diesson/buck_interleaved/Figuras/layout.png

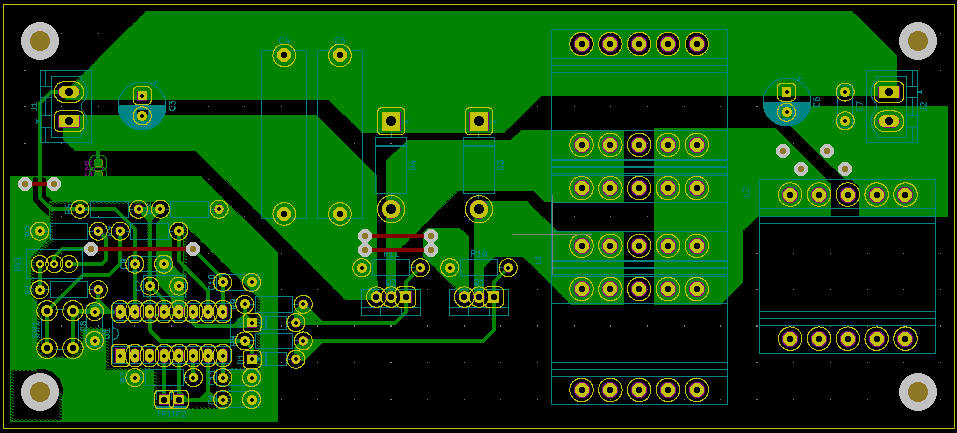
Figuras/layout.png
