diesson/buck_interleaved/Scripts/fig/cond/Acoplado com frequência de chaveamento 20kHz (Entreferro grande).png

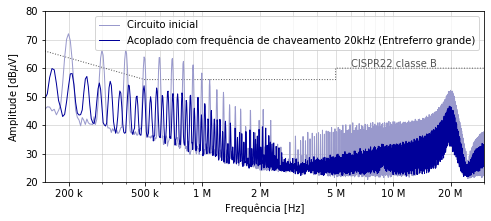
Scripts/fig/cond/Acoplado com frequência de chaveamento 20kHz (Entreferro grande).png
