diesson/buck_interleaved/Scripts/fig/cond/Alteração da posição do indutor.png

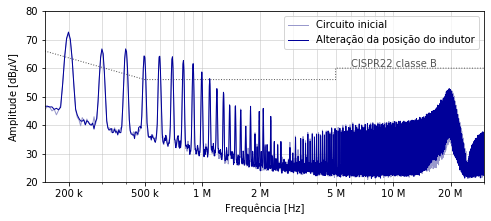
Scripts/fig/cond/Alteração da posição do indutor.png
