diesson/buck_interleaved/Scripts/fig/cond/Choke bead no terminal de dreno do transistor.png

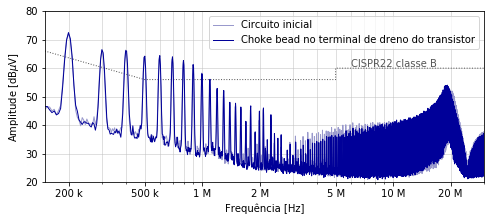
Scripts/fig/cond/Choke bead no terminal de dreno do transistor.png
