diesson/buck_interleaved/Scripts/fig/cond/Circuito inicial.png

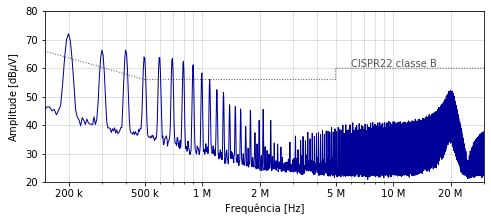
Scripts/fig/cond/Circuito inicial.png
