diesson/buck_interleaved/Scripts/fig/cond/Conectar o dissipador a referência (Capacitor de 1nF).png

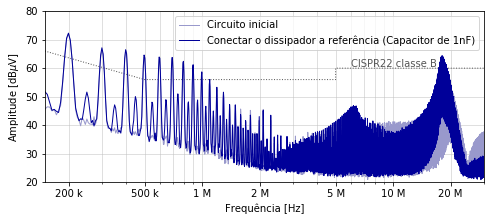
Scripts/fig/cond/Conectar o dissipador a referência (Capacitor de 1nF).png
