diesson/buck_interleaved/Scripts/fig/cond/Medida que n serve pra nada.png

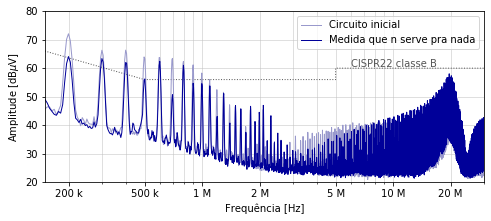
Scripts/fig/cond/Medida que n serve pra nada.png
