diesson/buck_interleaved/Scripts/fig/cond/Tensão Vgs 12V.png

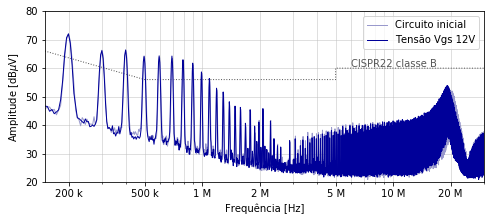
Scripts/fig/cond/Tensão Vgs 12V.png
