diesson/buck_interleaved/Scripts/fig/cond/Uso das melhores técnicas.png

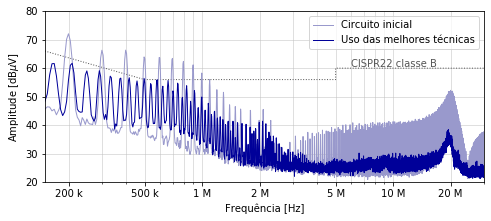
Scripts/fig/cond/Uso das melhores técnicas.png
