diesson/buck_interleaved/Scripts/fig/cond/Uso de um acoplado com frequência de chaveamento de 20kHz.png

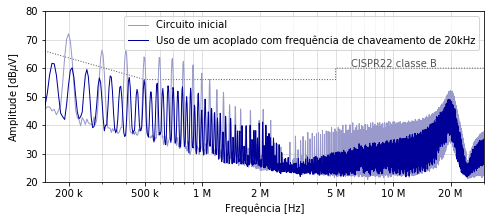
Scripts/fig/cond/Uso de um acoplado com frequência de chaveamento de 20kHz.png
