diesson/buck_interleaved/Scripts/fig/rad/Acoplado com frequência de chaveamento 20kHz (Entreferro grande).png

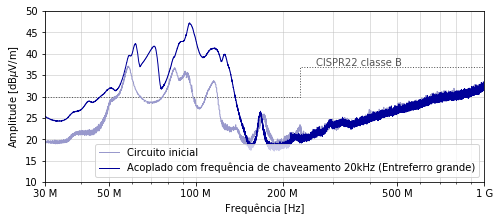
Scripts/fig/rad/Acoplado com frequência de chaveamento 20kHz (Entreferro grande).png
