diesson/buck_interleaved/Scripts/fig/rad/Acoplado com frequência de chaveamento 50kHz (Entreferro pequeno e indutor embaixo da placa).png

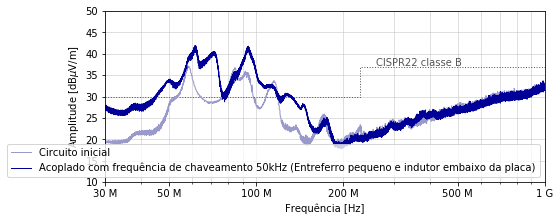
Scripts/fig/rad/Acoplado com frequência de chaveamento 50kHz (Entreferro pequeno e indutor embaixo da placa).png
