diesson/buck_interleaved/Scripts/fig/rad/Alteração da posição do indutor.png

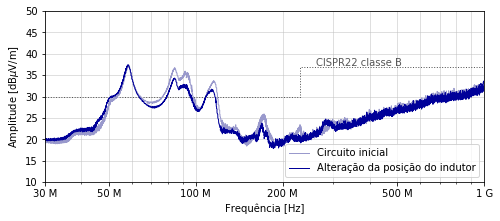
Scripts/fig/rad/Alteração da posição do indutor.png
