diesson/buck_interleaved/Scripts/fig/rad/Aumento do tr do transistor.png

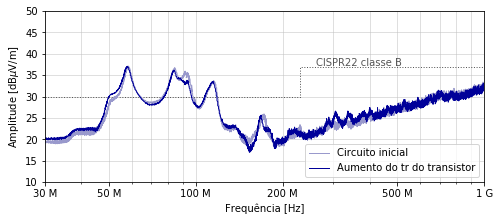
Scripts/fig/rad/Aumento do tr do transistor.png
