diesson/buck_interleaved/Scripts/fig/rad/Choke bead no terminal de dreno do transistor.png

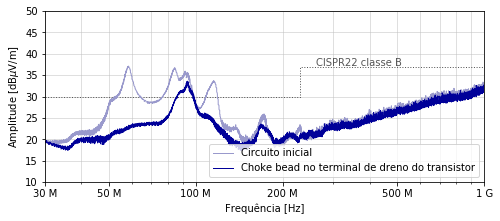
Scripts/fig/rad/Choke bead no terminal de dreno do transistor.png
