diesson/buck_interleaved/Scripts/fig/rad/Conectar o dissipador a referência (Capacitor de 1nF).png

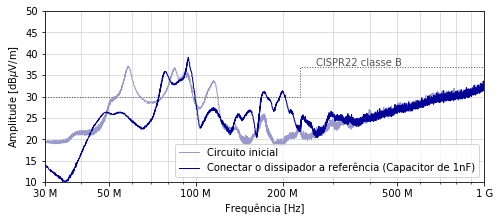
Scripts/fig/rad/Conectar o dissipador a referência (Capacitor de 1nF).png
