diesson/buck_interleaved/Scripts/fig/rad/Conectar o dissipador a referência (Capacitor de 100nF).png

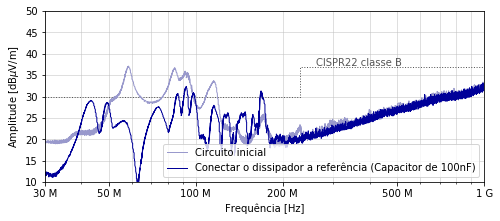
Scripts/fig/rad/Conectar o dissipador a referência (Capacitor de 100nF).png
