diesson/buck_interleaved/Scripts/fig/rad/Uso das melhores técnicas.png

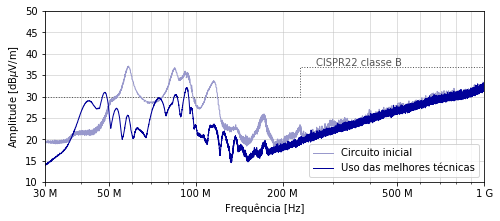
Scripts/fig/rad/Uso das melhores técnicas.png
