diesson/buck_interleaved/Scripts/fig/rad/Uso de um acoplado com frequência de chaveamento de 20kHz.png

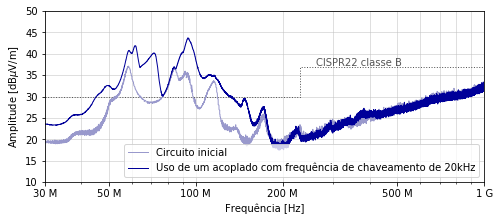
Scripts/fig/rad/Uso de um acoplado com frequência de chaveamento de 20kHz.png
