diesson/buck_interleaved/Scripts/fig/rad/Uso de um acoplado com frequência de chaveamento de 50kHz.png

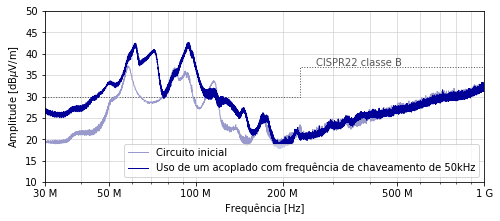
Scripts/fig/rad/Uso de um acoplado com frequência de chaveamento de 50kHz.png
