diesson/buck_interleaved/Scripts/TESTE/00_eixo_freq.xls

Frequency | PK+_CLRWR | Axis | Corr. | Comment
MHz | dBμV |  | dB
 | MaxPeak
Lin | Lin | Lin | Lin | Lin
30.000000 | --- |  | ---
30.040000 | --- |  | ---
30.080000 | --- |  | ---
30.120000 | --- |  | ---
30.160000 | --- |  | ---
30.200000 | --- |  | ---
30.240000 | --- |  | ---
30.280000 | --- |  | ---
30.320000 | --- |  | ---
30.360000 | --- |  | ---
30.400000 | --- |  | ---
30.440000 | --- |  | ---
30.480000 | --- |  | ---
30.520000 | --- |  | ---
30.560000 | --- |  | ---
30.600000 | --- |  | ---
30.640000 | --- |  | ---
30.680000 | --- |  | ---
30.720000 | --- |  | ---
30.760000 | --- |  | ---
30.800000 | --- |  | ---
30.840000 | --- |  | ---
30.880000 | --- |  | ---
30.920000 | --- |  | ---
30.960000 | --- |  | ---
31.000000 | --- |  | ---
31.040000 | --- |  | ---
31.080000 | --- |  | ---
31.120000 | --- |  | ---
31.160000 | --- |  | ---
31.200000 | --- |  | ---
31.240000 | --- |  | ---
31.280000 | --- |  | ---
31.320000 | --- |  | ---
31.360000 | --- |  | ---
31.400000 | --- |  | ---
31.440000 | --- |  | ---
31.480000 | --- |  | ---
31.520000 | --- |  | ---
31.560000 | --- |  | ---
31.600000 | --- |  | ---
31.640000 | --- |  | ---
31.680000 | --- |  | ---
31.720000 | --- |  | ---
31.760000 | --- |  | ---
31.800000 | --- |  | ---
31.840000 | --- |  | ---
31.880000 | --- |  | ---
31.920000 | --- |  | ---
31.960000 | --- |  | ---
32.000000 | --- |  | ---
32.040000 | --- |  | ---
32.080000 | --- |  | ---
32.120000 | --- |  | ---
32.160000 | --- |  | ---
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
188.680000 | --- |  | ---
188.720000 | --- |  | ---
188.760000 | --- |  | ---
188.800000 | --- |  | ---
188.840000 | --- |  | ---
188.880000 | --- |  | ---
188.920000 | --- |  | ---
188.960000 | --- |  | ---
189.000000 | --- |  | ---
189.040000 | --- |  | ---
189.080000 | --- |  | ---
189.120000 | --- |  | ---
189.160000 | --- |  | ---
189.200000 | --- |  | ---
189.240000 | --- |  | ---
189.280000 | --- |  | ---
189.320000 | --- |  | ---
189.360000 | --- |  | ---
189.400000 | --- |  | ---
189.440000 | --- |  | ---
189.480000 | --- |  | ---
189.520000 | --- |  | ---
189.560000 | --- |  | ---
189.600000 | --- |  | ---
189.640000 | --- |  | ---
189.680000 | --- |  | ---
189.720000 | --- |  | ---
189.760000 | --- |  | ---
189.800000 | --- |  | ---
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
