diesson/buck_interleaved/Scripts/TESTE/02_contra_porta_FD.xls

Frequency | PK+_CLRWR | Axis | Corr. | Comment
MHz | dBμV |  | dB
 | MaxPeak
Lin | Lin | Lin | Lin | Lin
30.000000 | 45.3 |  | 0.0
30.040000 | 45.3 |  | 0.0
30.080000 | 45.6 |  | 0.0
30.120000 | 45.6 |  | 0.0
30.160000 | 45.7 |  | 0.0
30.200000 | 45.4 |  | 0.0
30.240000 | 45.1 |  | 0.0
30.280000 | 45.2 |  | 0.0
30.320000 | 45.3 |  | 0.0
30.360000 | 45.7 |  | 0.0
30.400000 | 45.5 |  | 0.0
30.440000 | 45.2 |  | 0.0
30.480000 | 45.0 |  | 0.0
30.520000 | 45.0 |  | 0.0
30.560000 | 45.4 |  | 0.0
30.600000 | 45.4 |  | 0.0
30.640000 | 45.3 |  | 0.0
30.680000 | 45.1 |  | 0.0
30.720000 | 44.9 |  | 0.0
30.760000 | 45.0 |  | 0.0
30.800000 | 45.1 |  | 0.0
30.840000 | 45.4 |  | 0.0
30.880000 | 45.3 |  | 0.0
30.920000 | 44.9 |  | 0.0
30.960000 | 44.7 |  | 0.0
31.000000 | 44.7 |  | 0.0
31.040000 | 45.1 |  | 0.0
31.080000 | 45.2 |  | 0.0
31.120000 | 45.0 |  | 0.0
31.160000 | 44.8 |  | 0.0
31.200000 | 44.6 |  | 0.0
31.240000 | 44.7 |  | 0.0
31.280000 | 44.9 |  | 0.0
31.320000 | 45.0 |  | 0.0
31.360000 | 45.0 |  | 0.0
31.400000 | 44.7 |  | 0.0
31.440000 | 44.4 |  | 0.0
31.480000 | 44.5 |  | 0.0
31.520000 | 44.8 |  | 0.0
31.560000 | 45.1 |  | 0.0
31.600000 | 44.8 |  | 0.0
31.640000 | 44.5 |  | 0.0
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
