diesson/buck_interleaved/Scripts/TESTE/03_contra_porta_FE.xls

Frequency | PK+_CLRWR | Axis | Corr. | Comment
MHz | dBμV |  | dB
 | MaxPeak
Lin | Lin | Lin | Lin | Lin
30.000000 | 43.5 |  | 0.0
30.040000 | 43.8 |  | 0.0
30.080000 | 43.9 |  | 0.0
30.120000 | 44.0 |  | 0.0
30.160000 | 43.9 |  | 0.0
30.200000 | 43.5 |  | 0.0
30.240000 | 43.4 |  | 0.0
30.280000 | 43.5 |  | 0.0
30.320000 | 44.0 |  | 0.0
30.360000 | 44.1 |  | 0.0
30.400000 | 43.6 |  | 0.0
30.440000 | 43.4 |  | 0.0
30.480000 | 43.3 |  | 0.0
30.520000 | 43.6 |  | 0.0
30.560000 | 43.9 |  | 0.0
30.600000 | 43.8 |  | 0.0
30.640000 | 43.6 |  | 0.0
30.680000 | 43.3 |  | 0.0
30.720000 | 43.2 |  | 0.0
30.760000 | 43.5 |  | 0.0
30.800000 | 43.7 |  | 0.0
30.840000 | 43.9 |  | 0.0
30.880000 | 43.4 |  | 0.0
30.920000 | 43.1 |  | 0.0
30.960000 | 43.0 |  | 0.0
31.000000 | 43.4 |  | 0.0
31.040000 | 43.7 |  | 0.0
31.080000 | 43.6 |  | 0.0
31.120000 | 43.4 |  | 0.0
31.160000 | 43.1 |  | 0.0
31.200000 | 43.0 |  | 0.0
31.240000 | 43.2 |  | 0.0
31.280000 | 43.4 |  | 0.0
31.320000 | 43.7 |  | 0.0
31.360000 | 43.3 |  | 0.0
31.400000 | 43.0 |  | 0.0
31.440000 | 42.8 |  | 0.0
31.480000 | 43.1 |  | 0.0
31.520000 | 43.5 |  | 0.0
31.560000 | 43.5 |  | 0.0
31.600000 | 43.0 |  | 0.0
31.640000 | 42.9 |  | 0.0
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
