diesson/buck_interleaved/Scripts/TESTE/04_ponta.xls

Frequency | PK+_CLRWR | Axis | Corr. | Comment
MHz | dBμV |  | dB
 | MaxPeak
Lin | Lin | Lin | Lin | Lin
30.000000 | 28.4 |  | 0.0
30.040000 | 29.0 |  | 0.0
30.080000 | 29.3 |  | 0.0
30.120000 | 30.8 |  | 0.0
30.160000 | 30.5 |  | 0.0
30.200000 | 29.5 |  | 0.0
30.240000 | 28.2 |  | 0.0
30.280000 | 28.6 |  | 0.0
30.320000 | 30.2 |  | 0.0
30.360000 | 30.6 |  | 0.0
30.400000 | 30.2 |  | 0.0
30.440000 | 29.2 |  | 0.0
30.480000 | 29.0 |  | 0.0
30.520000 | 29.1 |  | 0.0
30.560000 | 30.1 |  | 0.0
30.600000 | 30.6 |  | 0.0
30.640000 | 30.9 |  | 0.0
30.680000 | 29.2 |  | 0.0
30.720000 | 28.0 |  | 0.0
30.760000 | 28.3 |  | 0.0
30.800000 | 30.3 |  | 0.0
30.840000 | 30.9 |  | 0.0
30.880000 | 30.6 |  | 0.0
30.920000 | 29.3 |  | 0.0
30.960000 | 28.7 |  | 0.0
31.000000 | 29.3 |  | 0.0
31.040000 | 30.2 |  | 0.0
31.080000 | 30.6 |  | 0.0
31.120000 | 30.5 |  | 0.0
31.160000 | 29.8 |  | 0.0
31.200000 | 29.0 |  | 0.0
31.240000 | 28.6 |  | 0.0
31.280000 | 30.3 |  | 0.0
31.320000 | 31.2 |  | 0.0
31.360000 | 30.5 |  | 0.0
31.400000 | 29.1 |  | 0.0
31.440000 | 28.3 |  | 0.0
31.480000 | 29.2 |  | 0.0
31.520000 | 31.0 |  | 0.0
31.560000 | 31.0 |  | 0.0
31.600000 | 30.3 |  | 0.0
31.640000 | 29.4 |  | 0.0
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
