diesson/buck_interleaved/Scripts/TESTE/05_contra_ponta.xls

Frequency | PK+_CLRWR | Axis | Corr. | Comment
MHz | dBμV |  | dB
 | MaxPeak
Lin | Lin | Lin | Lin | Lin
30.000000 | 29.5 |  | 0.0
30.040000 | 30.0 |  | 0.0
30.080000 | 30.1 |  | 0.0
30.120000 | 28.9 |  | 0.0
30.160000 | 28.3 |  | 0.0
30.200000 | 28.1 |  | 0.0
30.240000 | 28.6 |  | 0.0
30.280000 | 30.6 |  | 0.0
30.320000 | 30.3 |  | 0.0
30.360000 | 28.5 |  | 0.0
30.400000 | 27.6 |  | 0.0
30.440000 | 27.9 |  | 0.0
30.480000 | 30.2 |  | 0.0
30.520000 | 30.4 |  | 0.0
30.560000 | 30.3 |  | 0.0
30.600000 | 28.6 |  | 0.0
30.640000 | 28.1 |  | 0.0
30.680000 | 29.0 |  | 0.0
30.720000 | 29.1 |  | 0.0
30.760000 | 30.6 |  | 0.0
30.800000 | 30.7 |  | 0.0
30.840000 | 29.1 |  | 0.0
30.880000 | 27.8 |  | 0.0
30.920000 | 27.9 |  | 0.0
30.960000 | 30.0 |  | 0.0
31.000000 | 30.8 |  | 0.0
31.040000 | 30.3 |  | 0.0
31.080000 | 28.5 |  | 0.0
31.120000 | 28.1 |  | 0.0
31.160000 | 28.7 |  | 0.0
31.200000 | 29.7 |  | 0.0
31.240000 | 30.3 |  | 0.0
31.280000 | 30.2 |  | 0.0
31.320000 | 29.6 |  | 0.0
31.360000 | 28.2 |  | 0.0
31.400000 | 28.4 |  | 0.0
31.440000 | 29.8 |  | 0.0
31.480000 | 30.8 |  | 0.0
31.520000 | 30.2 |  | 0.0
31.560000 | 28.9 |  | 0.0
31.600000 | 27.6 |  | 0.0
31.640000 | 28.8 |  | 0.0
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
