diesson/buck_interleaved/Scripts/fig/cond/pdf/Uso de um acoplado com frequência de chaveamento de 20kHz.pdf

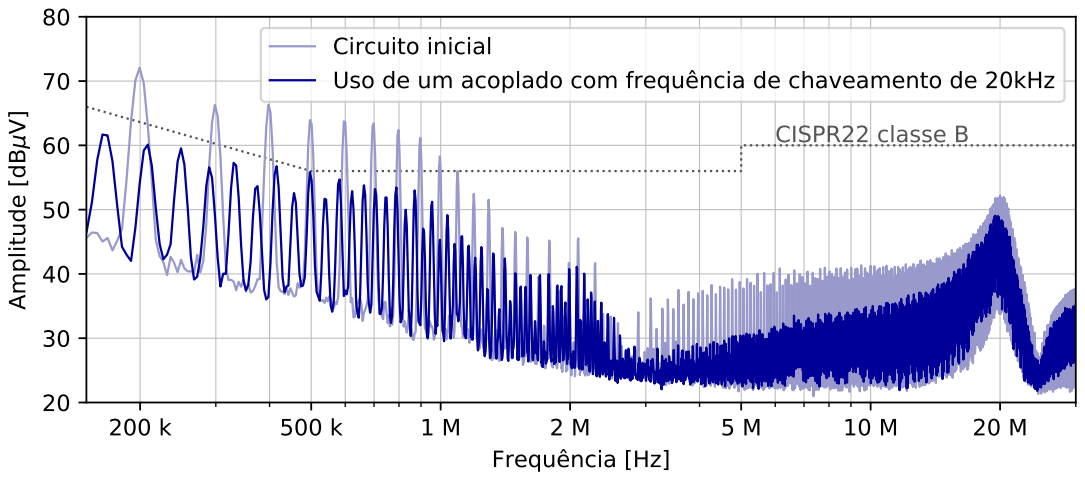
[picture p23: page 1]
Frequência [Hz]; plitu

Circuito inicial Uso de um acoplado com frequência de chaveamento de 20kHz

CISPR22 classe B
