diesson/buck_interleaved/Scripts/fig/cond/pdf/Uso de um acoplado com frequência de chaveamento de 50kHz.pdf

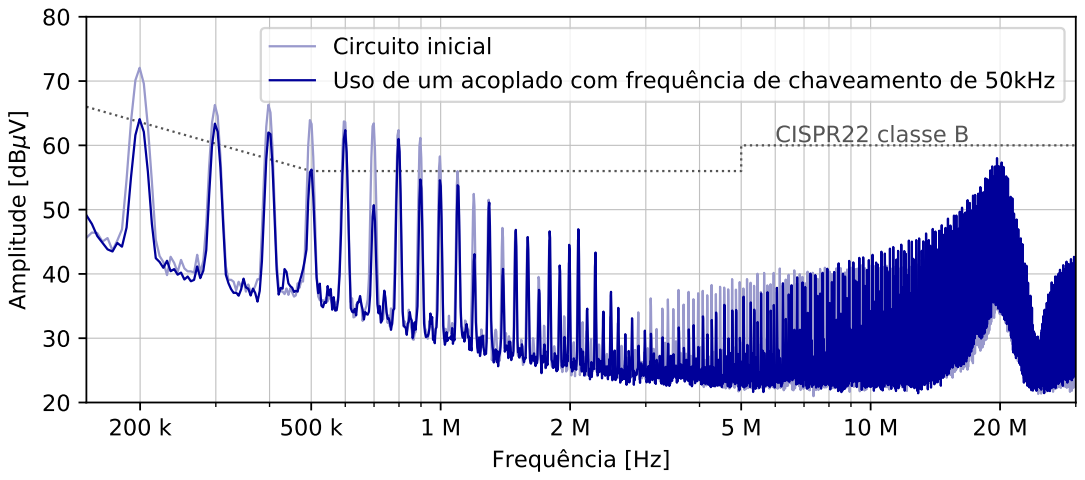
[picture p24: page 1]
Frequência [Hz]; plitu

Circuito inicial Uso de um acoplado com frequência de chaveamento de 50kHz

CISPR22 classe B
