diesson/buck_interleaved/Scripts/fig/rad/pdf/Uso de um acoplado com frequência de chaveamento de 20kHz.pdf

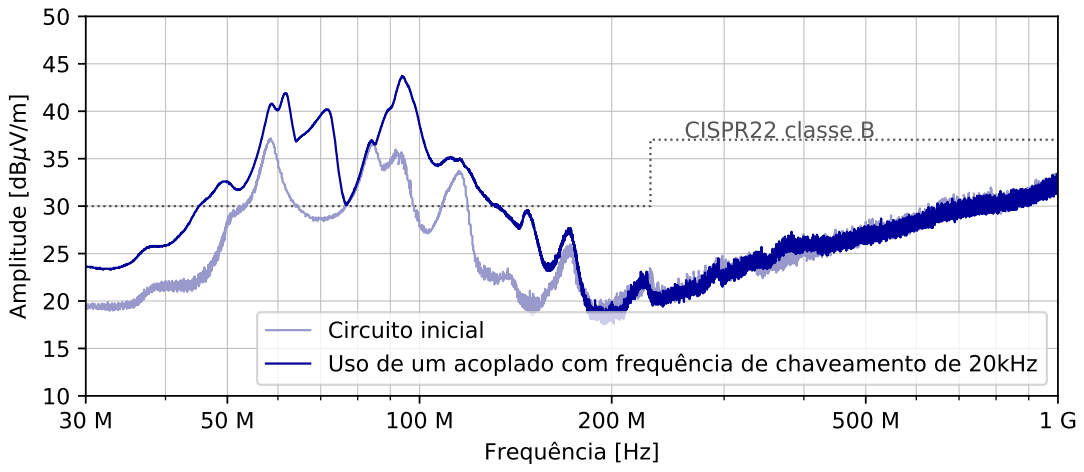
[picture p25: page 1]
Frequência [Hz]; plitu; CISPR22 classe B

Circuito inicial
Uso de um acoplado com frequência de chaveamento de 20kHz
