diesson/buck_interleaved/Circuito.pdf

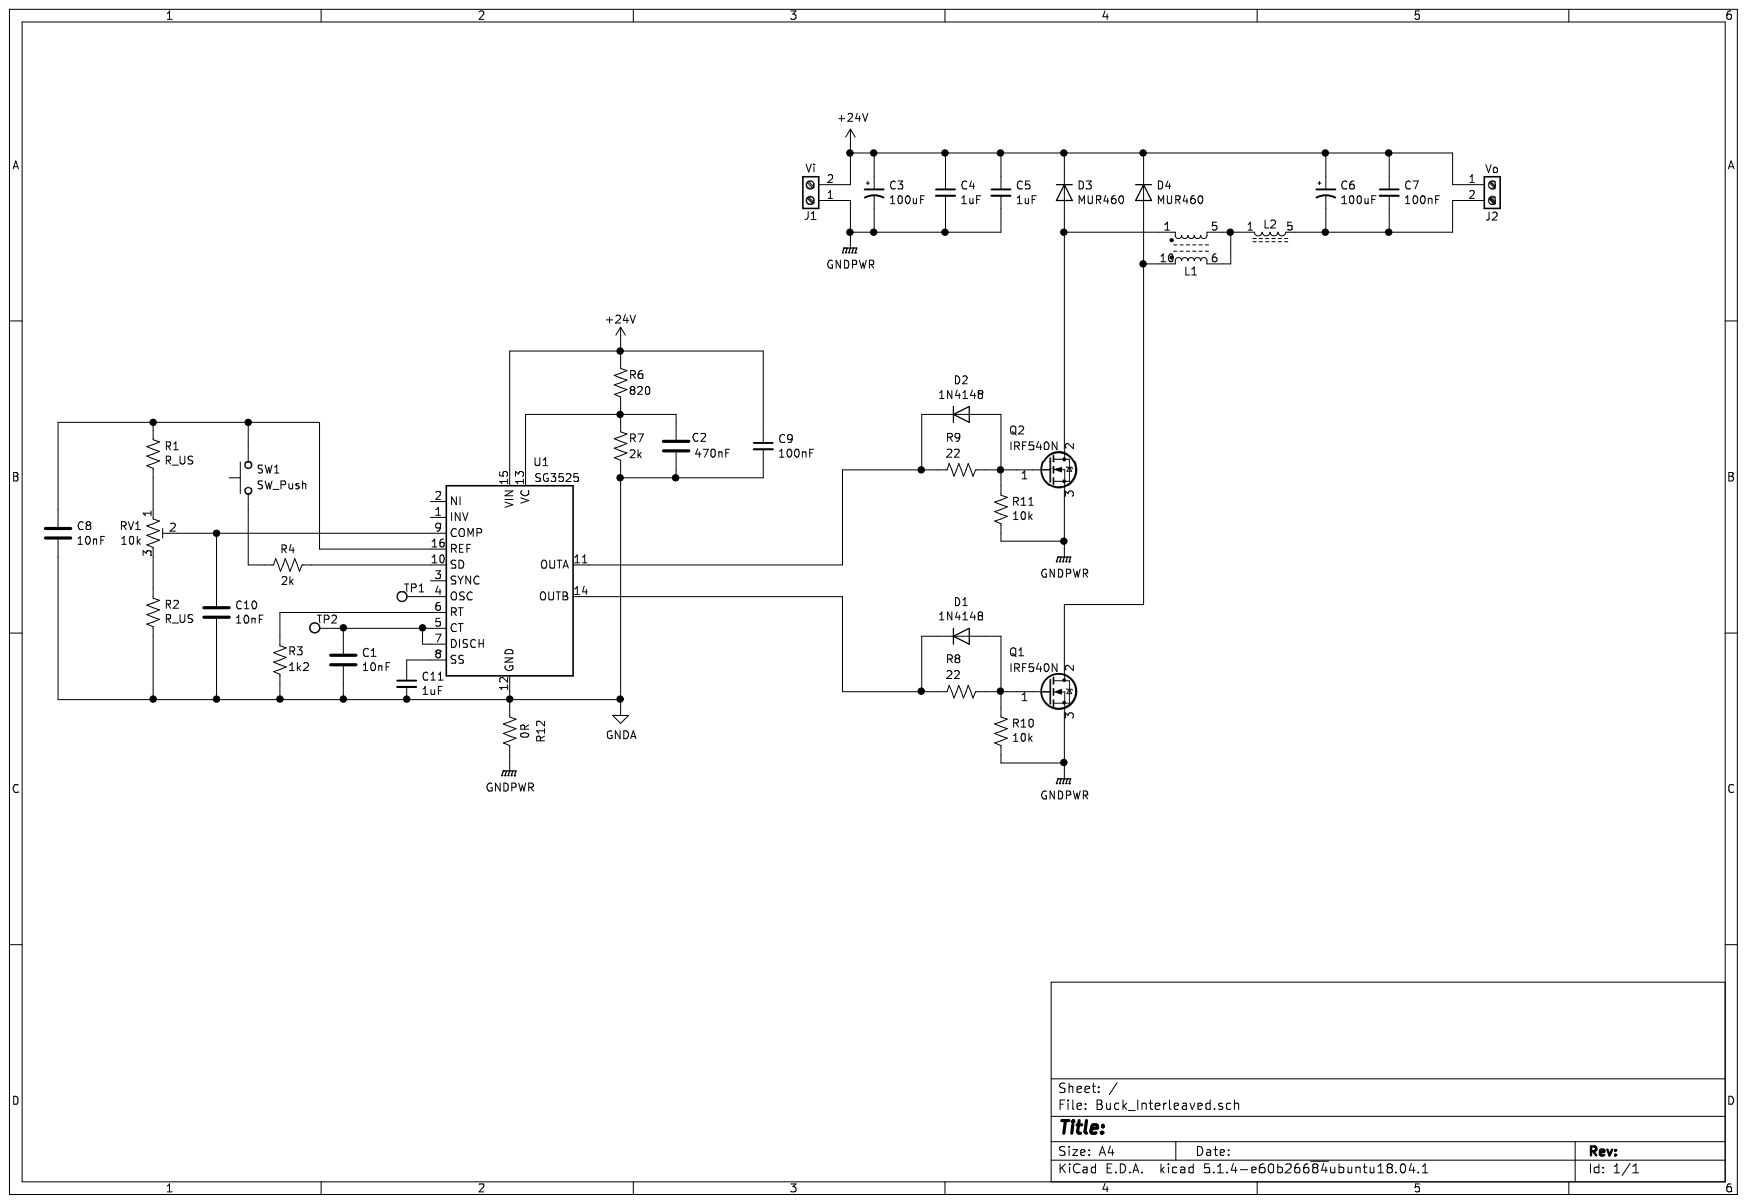
[picture p26: page 1]
