diesson/buck_interleaved/Scripts/fig/cond/pdf/Choke bead no terminal de dreno do transistor.pdf

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

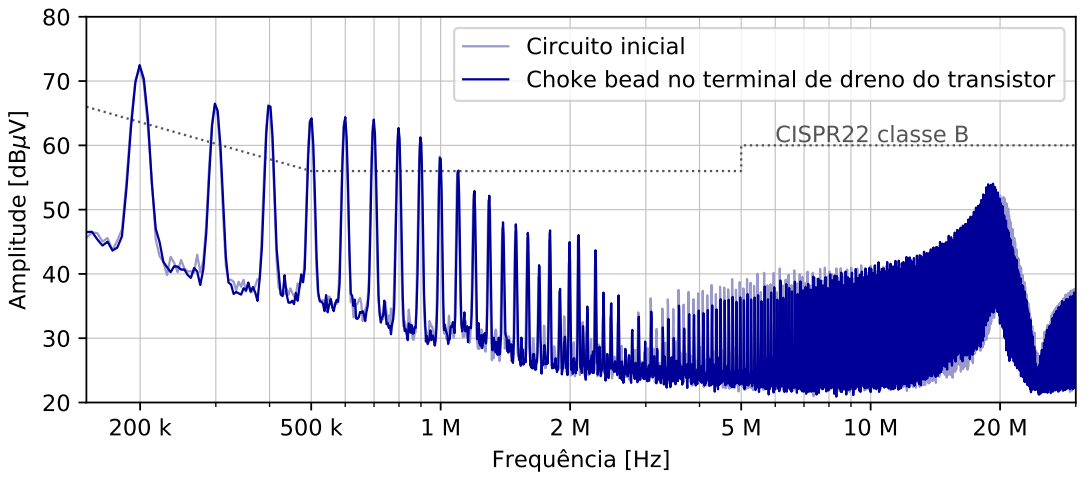
[picture p30: page 1]
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
