diesson/buck_interleaved/Scripts/fig/cond/pdf/Circuito inicial.pdf

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

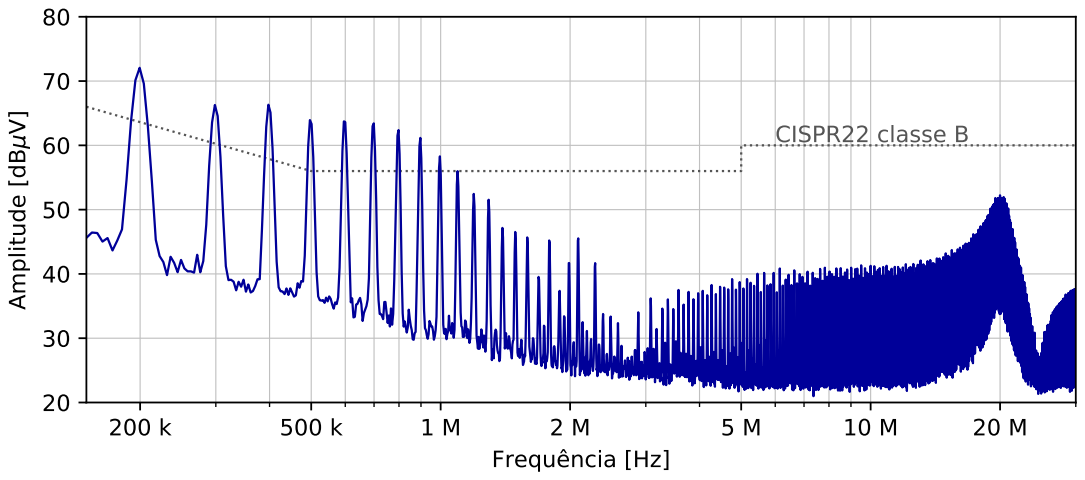
[picture p31: page 1]
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
