diesson/buck_interleaved/Scripts/fig/cond/pdf/Conectar o dissipador a referência (Capacitor de 100nF).pdf

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

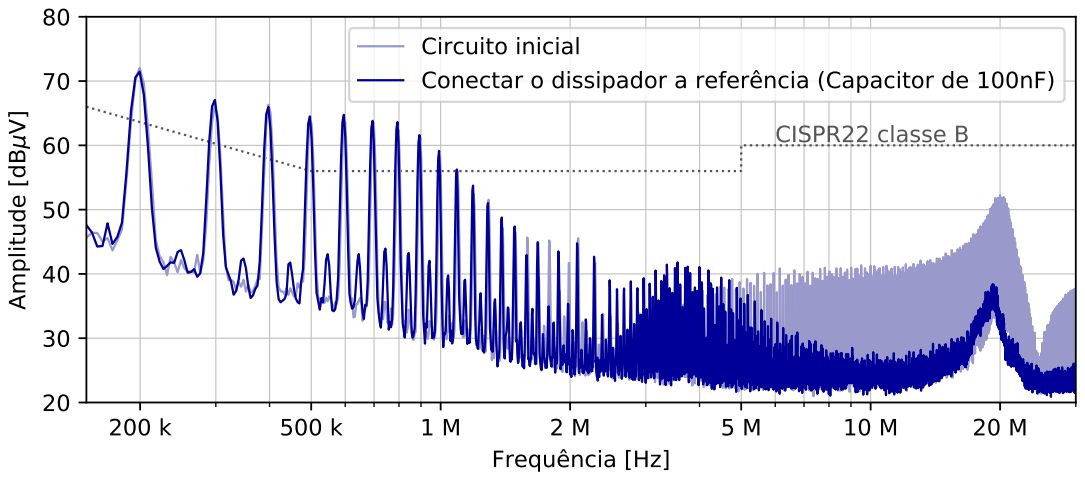
[picture p32: page 1]
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
