diesson/buck_interleaved/Scripts/fig/cond/pdf/Medida que n serve pra nada.pdf

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

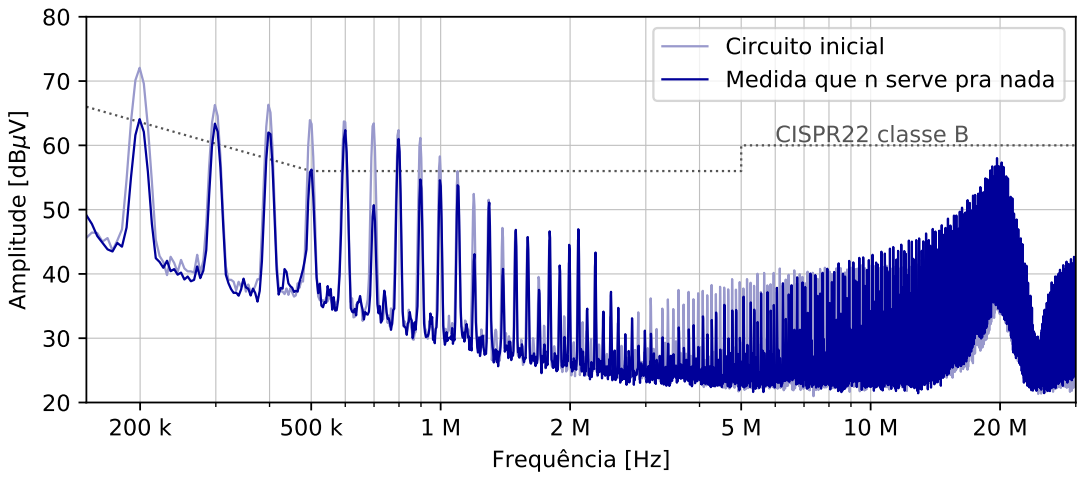
[picture p34: page 1]
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
