diesson/buck_interleaved/Scripts/fig/cond/pdf/Uso das melhores técnicas.pdf

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

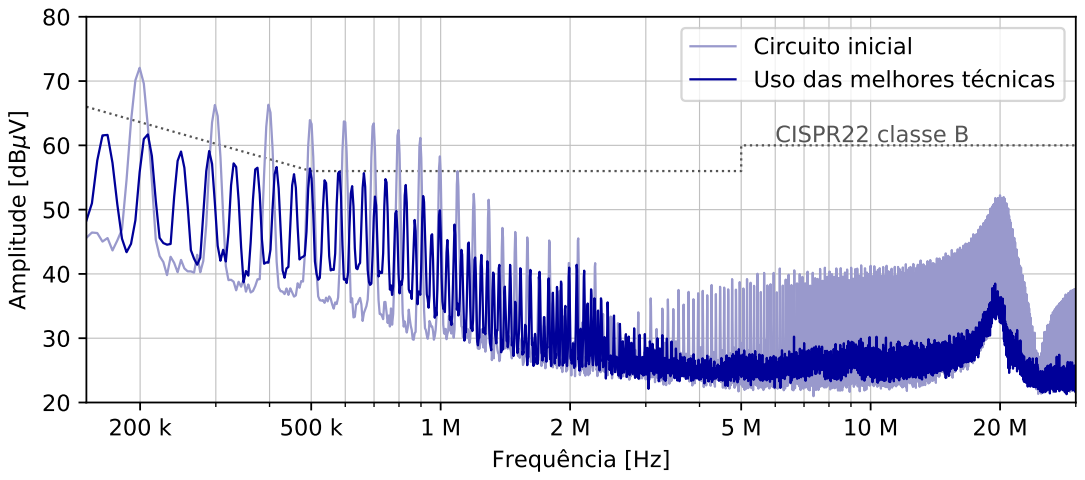
[picture p38: page 1]
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
