diesson/buck_interleaved/Scripts/fig/rad/pdf/Acoplado com frequência de chaveamento 50kHz (Entreferro pequeno e indutor embaixo da placa).pdf

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

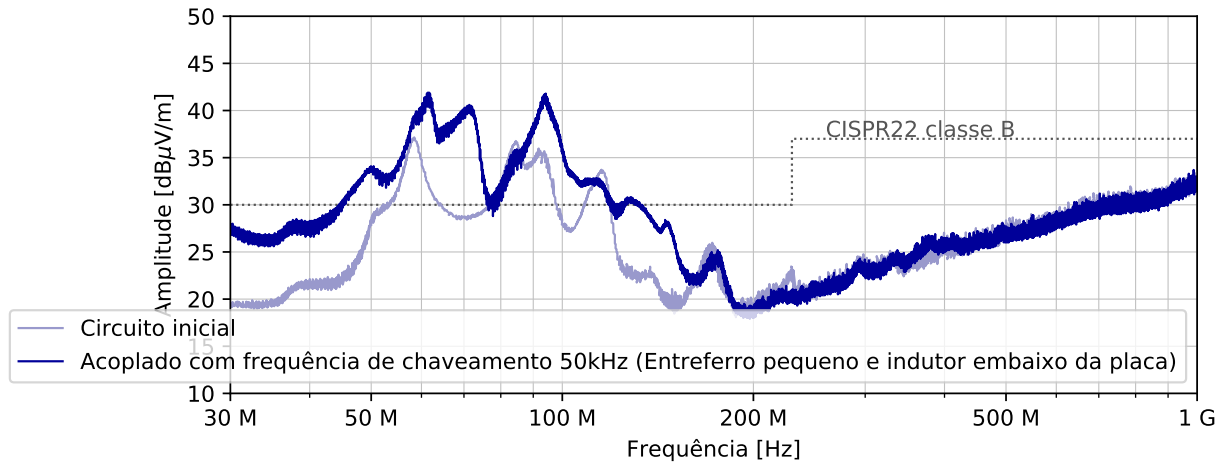
[picture p40: page 1]
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
