diesson/buck_interleaved/Scripts/fig/rad/pdf/Conectar o dissipador a referência (Capacitor de 1nF).pdf

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

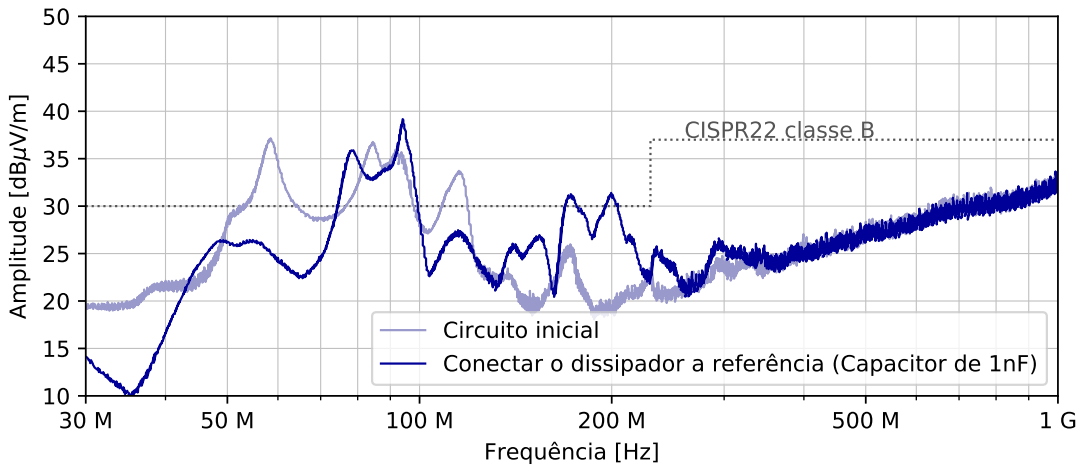
[picture p46: page 1]
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
