diesson/buck_interleaved/Scripts/fig/rad/pdf/Remoção do dissipador.pdf

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

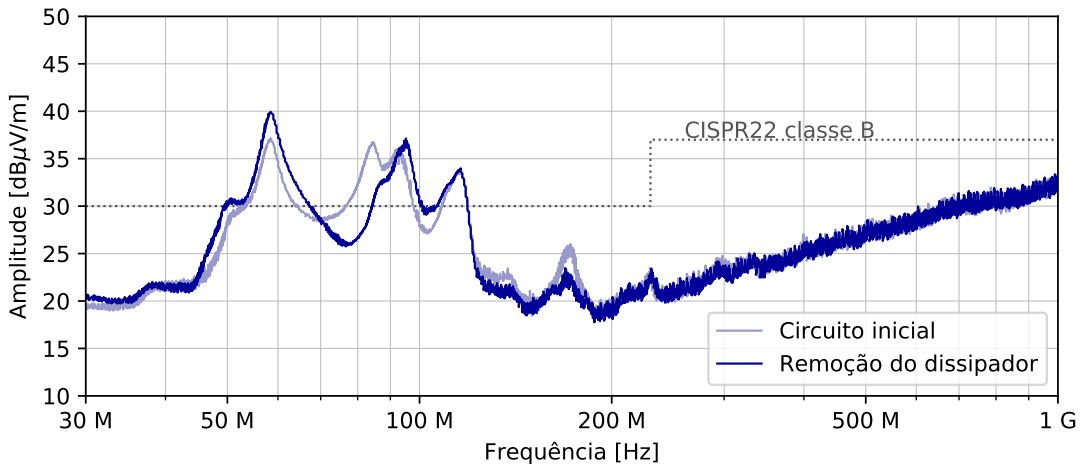
[picture p47: page 1]
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
