diesson/buck_interleaved/Projeto/Buck_Interleaved.asc

C1: cap; 470n
C2: cap; 10nF
C3: cap; 50µ; Rser=0.03
C4: cap; 1µ
D1: diode; 1N4148
D2: diode; MUR460
D3: diode; MUR460
D5: diode; 1N4148
L1: ind; 27µ
L2: ind; 27µ
L3: ind; 100nH
R1: res; 1k; tol=5 pwr=0.25
R2: res; 2k; tol=5 pwr=0.25
R3: res; 1k2; tol=5 pwr=0.25
R4: res; 10m
R6: res; 22; tol=5 pwr=0.25
R7: res; 10k; tol=5 pwr=0.25
R8: res; 22; tol=5 pwr=0.25
R9: res; 10k; tol=5 pwr=0.25
R10: res; 1
U1: SG3525A
U2: irf540
U3: irf540
U4: pot; Rt=10K set=0.625
V1: voltage; 24
Named nets: +24v, 0, G2, G1, Vsource
.tran 0 2m 0 2e-8 startup
