diesson/buck_interleaved/Projeto/Buck_Interleaved_v3.asc

C1: cap; 470nF
C2: cap; 10nF
C3: cap; 940µ
C4: cap; 47nF
D1: diode; 1N4148
D2: diode; MUR460
D3: diode; MUR460
D5: diode; 1N4148
L1: ind2; 35.7µ
L2: ind2; 35.7µ
L3: ind; 35.7µ
L4: ind; 10n
L5: ind; 10n
R1: res; 820; tol=5 pwr=0.25
R2: res; 2k; tol=5 pwr=0.25
R3: res; 3k6; tol=5 pwr=0.25
R4: res; 40m
R5: res; 0.5
R6: res; 22; tol=5 pwr=0.25
R7: res; 10k; tol=5 pwr=0.25
R8: res; 22; tol=5 pwr=0.25
R9: res; 10k; tol=5 pwr=0.25
R10: res; 1
U1: SG3525A
U2: irf540
U3: irf540
U4: pot; Rt=10K set=0.63
V1: voltage; 24
Named nets: +24v, 0, G2, G1, Vout
.tran 0 5m 0 1e-8 startup
K1 L1 L2 1.
