diesson/buck_interleaved/KiCAD/Buck_Interleaved.kicad_pcb

## KiCad design KiCAD/Buck_Interleaved.kicad_pcb (2020-03-29)

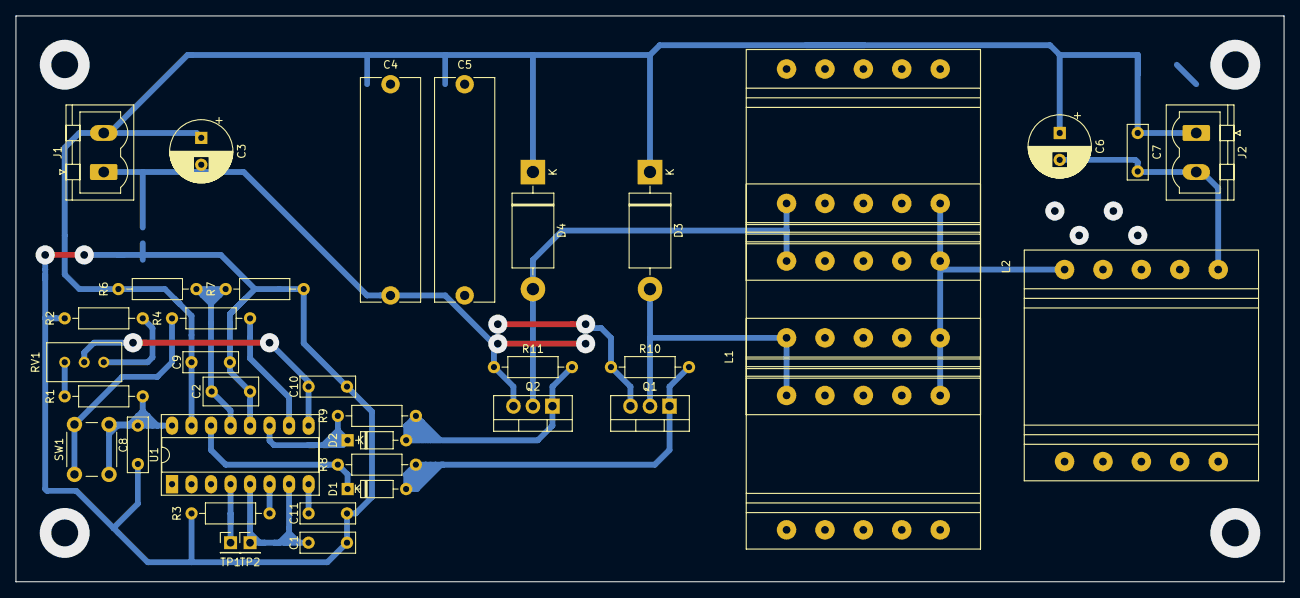
[picture p51: board Buck_Interleaved.kicad_pcb from above]

Board: 2 copper layers, 165.1 x 73.7 mm, 37 parts (1 on the bottom side), 22 nets.

Parts:
C1, C8, C10: 10nF; C_Rect_L7.0mm_W2.5mm_P5.00mm
C2: 470nF; C_Rect_L7.0mm_W3.5mm_P5.00mm
C3, C6: 100uF; CP_Radial_D8.0mm_P3.50mm
C4, C5: 1uF; C_Rect_L29.0mm_W7.6mm_P27.50mm_MKT
C7, C9: 100nF; C_Rect_L7.0mm_W2.5mm_P5.00mm
C11: 1uF; C_Rect_L7.0mm_W2.5mm_P5.00mm
D1, D2: 1N4148; D_DO-35_SOD27_P7.62mm_Horizontal
D3, D4: MUR460; D_DO-201AD_P15.24mm_Horizontal
J1: Vi; PhoenixContact_MSTBVA_2,5_2-G-5,08_1x02_P5.08mm_Vertical
J2: Vo; PhoenixContact_MSTBVA_2,5_2-G-5,08_1x02_P5.08mm_Vertical
L1: array_indutor; Ind_Carretel_E30_15_7_2
L2: indutor_u; Ind_Carretel_E30_15_7
Q1, Q2: IRF540N; TO-220-3_Vertical
R1, R2: R_US; R_Axial_DIN0207_L6.3mm_D2.5mm_P10.16mm_Horizontal
R3: 1k2; R_Axial_DIN0207_L6.3mm_D2.5mm_P10.16mm_Horizontal
R4, R7: 2k; R_Axial_DIN0207_L6.3mm_D2.5mm_P10.16mm_Horizontal
R6: 820; R_Axial_DIN0207_L6.3mm_D2.5mm_P10.16mm_Horizontal
R8, R9: 22; R_Axial_DIN0207_L6.3mm_D2.5mm_P10.16mm_Horizontal
R10, R11: 10k; R_Axial_DIN0207_L6.3mm_D2.5mm_P10.16mm_Horizontal
R12: 0R; R_0805_2012Metric_Pad1.15x1.40mm_HandSolder
RV1: 10k; Potentiometer_Bourns_3296W_Vertical
SW1: SW_Push; SW_PUSH_6mm_H5mm
TP1, TP2: TestPoint; PinHeader_1x01_P2.54mm_Vertical
U1: SG3525; DIP-16_W7.62mm_Socket_LongPads

Connections:
+24V: C3.1, C4.1, C5.1, C6.1, C7.1, C9.1, D3.1, D4.1, J1.2, J2.1, R6.1, U1.15
GNDA: C1.2, C2.1, C8.2, C9.2, C10.2, C11.2, R2.1, R3.1, R7.2, R12.2, U1.12
GNDPWR: C3.2, C4.2, C5.2, J1.1, Q1.3, Q2.3, R10.1, R11.1, R12.1
unnamed: C1.1, TP2.1, U1.5, U1.7
unnamed: C2.2, R6.2, R7.1, U1.13
unnamed: C6.2, C7.2, J2.2, L2.4, L2.5
unnamed: C8.1, R1.2, SW1.2, U1.16
unnamed: C10.1, RV1.2, U1.9
unnamed: C11.1, U1.8
unnamed: D1.1, R8.1, U1.14
unnamed: D1.2, Q1.1, R8.2, R10.2
unnamed: D2.1, R9.1, U1.11
unnamed: D2.2, Q2.1, R9.2, R11.2
unnamed: D3.2, L1.1, L1.2, Q1.2
unnamed: D4.2, L1.9, L1.10, Q2.2
unnamed: L1.4, L1.5, L1.6, L1.7, L2.1, L2.2
unnamed: R1.1, RV1.1
unnamed: R2.2, RV1.3
unnamed: R3.2, U1.6
unnamed: R4.1, U1.10
unnamed: R4.2, SW1.1
unnamed: TP1.1, U1.4
